vtl/volvo-kenwood/controls.jpg

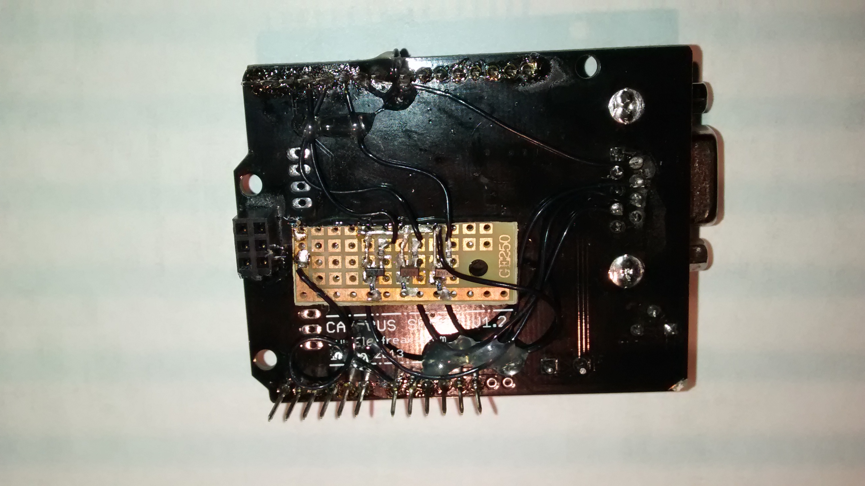
controls.jpg
