vtl/volvo-kenwood/canbus_shield_reset.jpg

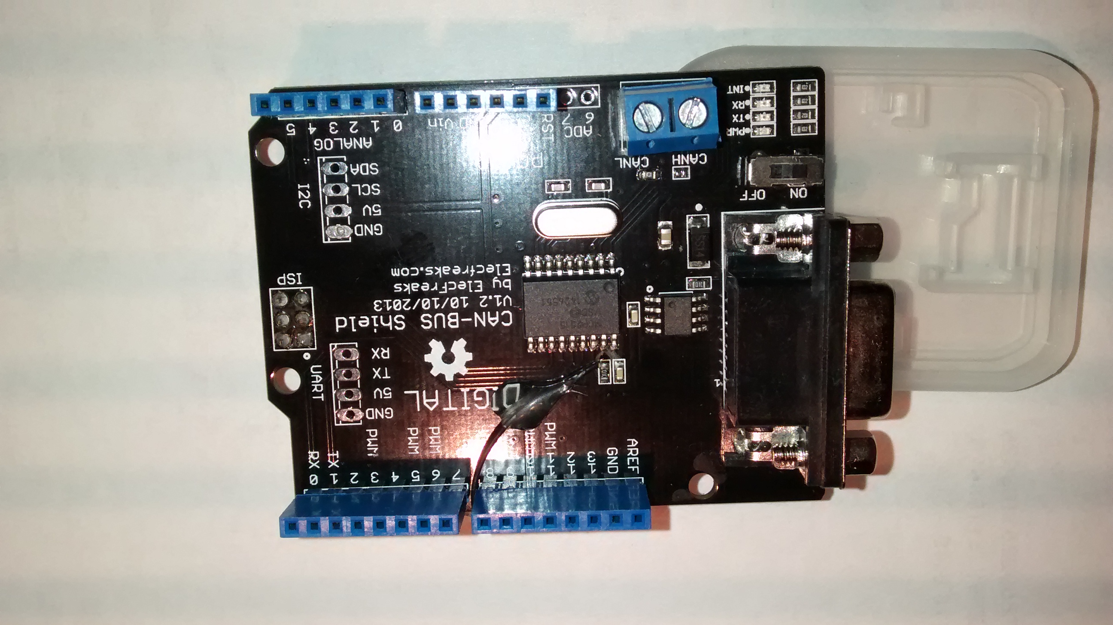
canbus_shield_reset.jpg
