vtl/volvo-kenwood/kenwood.png

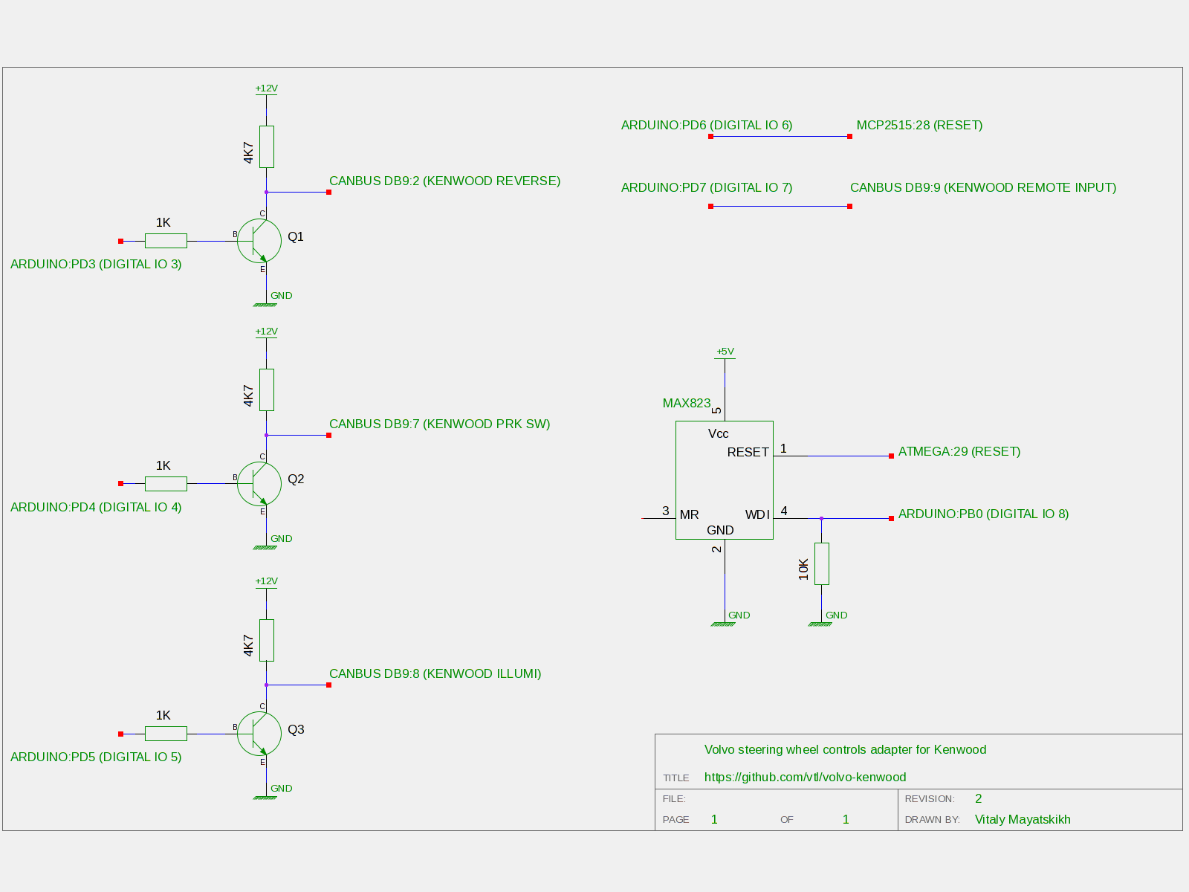
kenwood.png
