vtl/volvo-kenwood/watchdog.jpg

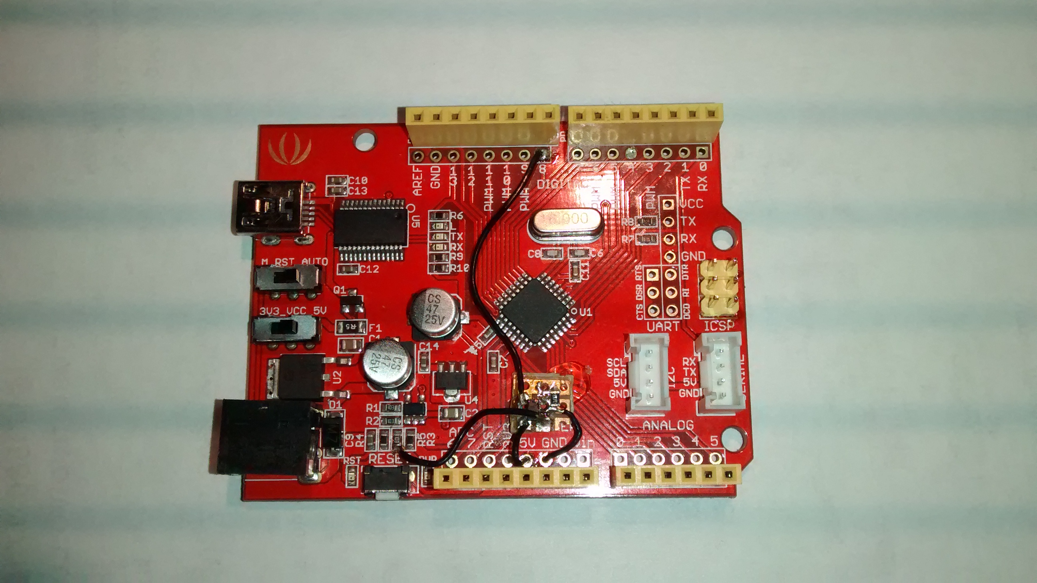
watchdog.jpg
