vtl/volvo-kenwood/(threads)

Thread 1 (2019-01-28):

CAN Connection

DarrenCarterSA, 2019-01-28:
Hello,

Would you mind sharing where/how you tapped into the vehicles CAN Bus?

I've tried behind the radio but just ended up tweaking out the DIM requiring a power cycle to get the thing responding again.

vtl, 2019-01-28:
Behind the radio, through the green connector.

Did you connect it to the right pins? CAN-H to CAN-H, CAN-L to CAN-L?
