vtl/volvo-kenwood/(commit log)

2014-11-25 Use pin 6 for MCP2515 reset
    [kenwood.ino]
2014-12-06 Set output pin mode in each transfer. Add simple watchdog.
2015-01-30 Drive MAX823 WDI pin.
2015-04-17 Previous track + volume up kicks a reboot.
    [kenwood.ino]
2015-04-20 Fix typos and add custom schematics
    [kenwood.sch]
2015-06-10 Touch software watchdog only for meaningful CAN messages.
    That would automatically reset the board if MCP programming failed.
    Also set CAN_RESET pin mode on every reset.
    [kenwood.ino]
2015-10-06 Support PRND gearbox switch.
2015-11-21 Update notes, schematics and pics.
    [kenwood.sch]
